Zhou-wy/Electronic-design/MYLIB/encode.c

#include "encode.h"

static void TIM4_Mode_Config(void)
{
    NVIC_InitTypeDef NVIC_InitStructure;
	GPIO_InitTypeDef GPIO_InitStructure;
	TIM_TimeBaseInitTypeDef  TIM_TimeBaseStructure;
	TIM_ICInitTypeDef TIM_ICInitStructure;   	

	RCC_APB1PeriphClockCmd(RCC_APB1Periph_TIM4, ENABLE);
	RCC_APB2PeriphClockCmd(RCC_APB2Periph_GPIOB, ENABLE);
	
	/*- 正交编码器输入引脚 PB->6   PB->7 -*/
	GPIO_InitStructure.GPIO_Pin = GPIO_Pin_6 | GPIO_Pin_7;         
	GPIO_InitStructure.GPIO_Mode = GPIO_Mode_IPU;
	GPIO_InitStructure.GPIO_Speed = GPIO_Speed_50MHz;
	GPIO_Init(GPIOB, &GPIO_InitStructure);                           

	/*- TIM4编码器模式配置 -*/
	TIM_DeInit(TIM4);
	TIM_TimeBaseStructure.TIM_Period = xian * 2;  
	TIM_TimeBaseStructure.TIM_Prescaler = 0;
	TIM_TimeBaseStructure.TIM_ClockDivision =TIM_CKD_DIV1 ;
	TIM_TimeBaseStructure.TIM_CounterMode = TIM_CounterMode_Up;
	TIM_TimeBaseInit(TIM4, &TIM_TimeBaseStructure);              
                 
	TIM_EncoderInterfaceConfig(TIM4, TIM_EncoderMode_TI1, TIM_ICPolarity_Rising ,TIM_ICPolarity_Rising);	//配置编码器模式触发源和极性
	
	TIM_ICStructInit(&TIM_ICInitStructure);																																		//配置滤波器
	TIM_ICInitStructure.TIM_ICFilter = 6;
	TIM_ICInit(TIM4, &TIM_ICInitStructure);
	


    /* Enable the TIM2 global Interrupt */
    NVIC_InitStructure.NVIC_IRQChannel = TIM4_IRQn;
    NVIC_InitStructure.NVIC_IRQChannelPreemptionPriority = 0;
    NVIC_InitStructure.NVIC_IRQChannelSubPriority = 0;
    NVIC_InitStructure.NVIC_IRQChannelCmd = ENABLE;
    NVIC_Init(&NVIC_InitStructure); 

	TIM4->CNT = 0;

	TIM_Cmd(TIM4, ENABLE);   //启动TIM4定时器
}

void TIM4_Init(void)
{
  TIM4_Mode_Config();
}
