Zhou-wy/Electronic-design/SYSTEM/led.h

#ifndef _led_H
#define _led_H

#include "stm32f10x.h"

/*  LED时钟端口、引脚定义 */
#define LED_PORT 			GPIOA   
#define LED_PIN 			(GPIO_Pin_0|GPIO_Pin_1)
#define LED_PORT_RCC	RCC_APB2Periph_GPIOA
#define LED_y         PAout(0)
#define LED_G         PAout(1)
	
void LED_Init(void);


#endif
