Zhou-wy/Electronic-design/USER/include.h

#include "stm32f10x.h"
#include "delay.h"
#include "usart.h"
#include "My_PWM.h"
#include "PID.h"
#include "6050_USART.h"
#include "Ultrasonic.h"
#include "TIM_interrupt.h"
#include "Control.h"
#include "Debug.h"
