Zhou-wy/Electronic-design/(notices)

Notices in the files:
SYSTEM/usart/usart.c:
Copyright(C) ¹ãÖÝÊÐÐÇÒíµç×Ó¿Æ¼¼ÓÐÏÞ¹«Ë¾ 2009-2019
All rights reserved
